TibeKnuts001/Round-chessboard/hardware/Pictures/DSC_0005.JPG

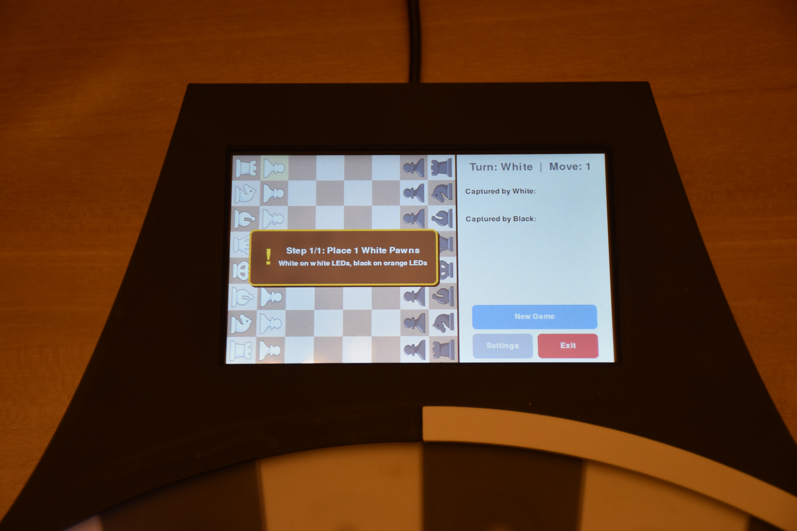
hardware/Pictures/DSC_0005.JPG
