TibeKnuts001/Round-chessboard/hardware/Pictures/DSC_0003.JPG

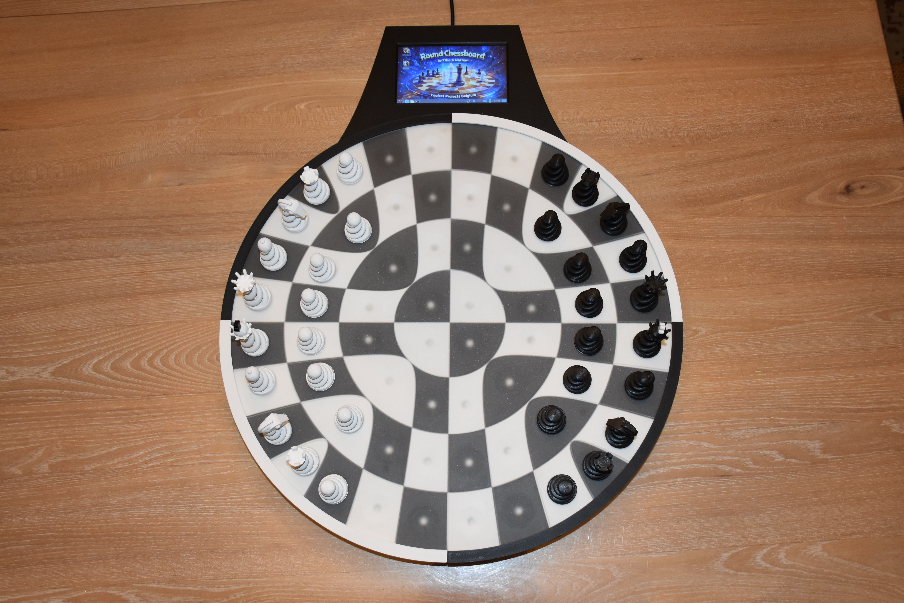
hardware/Pictures/DSC_0003.JPG
