TibeKnuts001/Round-chessboard/assets/checkers_pieces/black_king.png

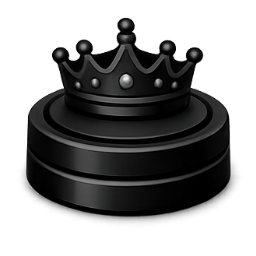
assets/checkers_pieces/black_king.png
