TibeKnuts001/Round-chessboard/assets/checkers_pieces/black_man.png

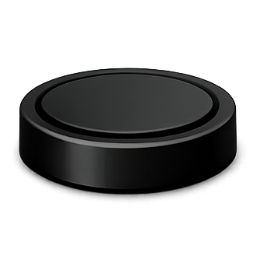
assets/checkers_pieces/black_man.png
