TibeKnuts001/Round-chessboard/assets/checkers_pieces/checkers_original_by_chatgpt.png

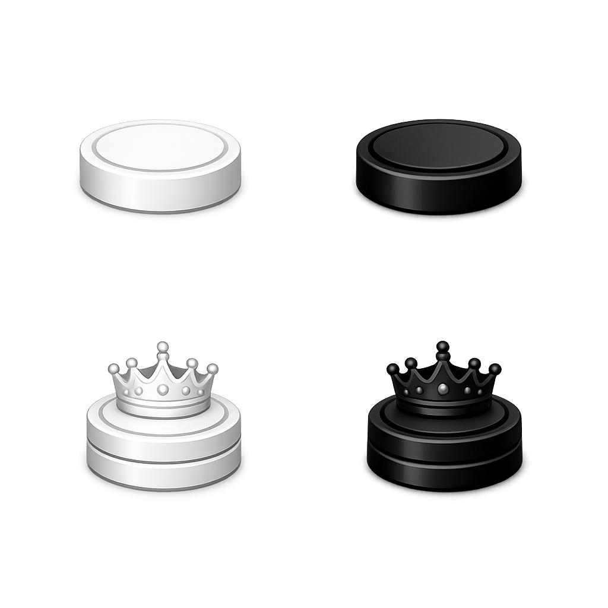
assets/checkers_pieces/checkers_original_by_chatgpt.png
