TibeKnuts001/Round-chessboard/assets/checkers_pieces/white_king.png

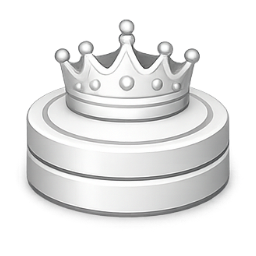
assets/checkers_pieces/white_king.png
