TibeKnuts001/Round-chessboard/assets/checkers_pieces/white_man.png

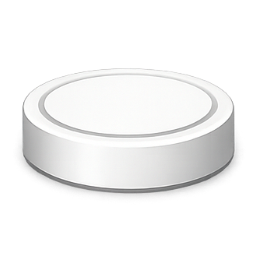
assets/checkers_pieces/white_man.png
