TibeKnuts001/Round-chessboard/assets/chess_pieces/black_bishop.png

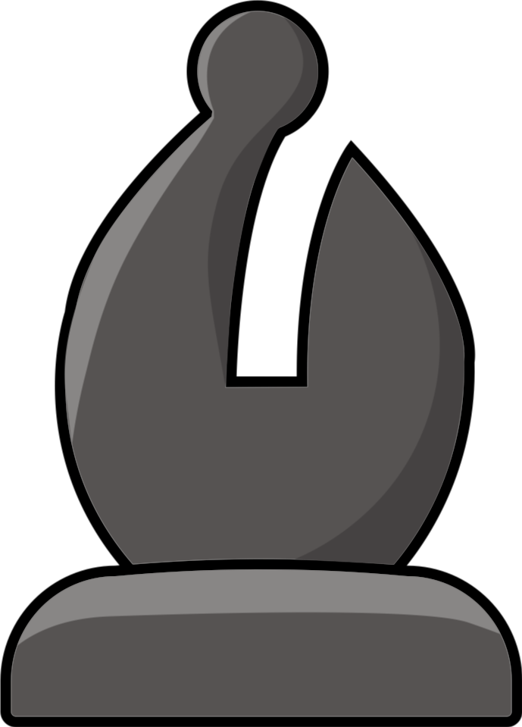
assets/chess_pieces/black_bishop.png
