TibeKnuts001/Round-chessboard/assets/chess_pieces/black_king.png

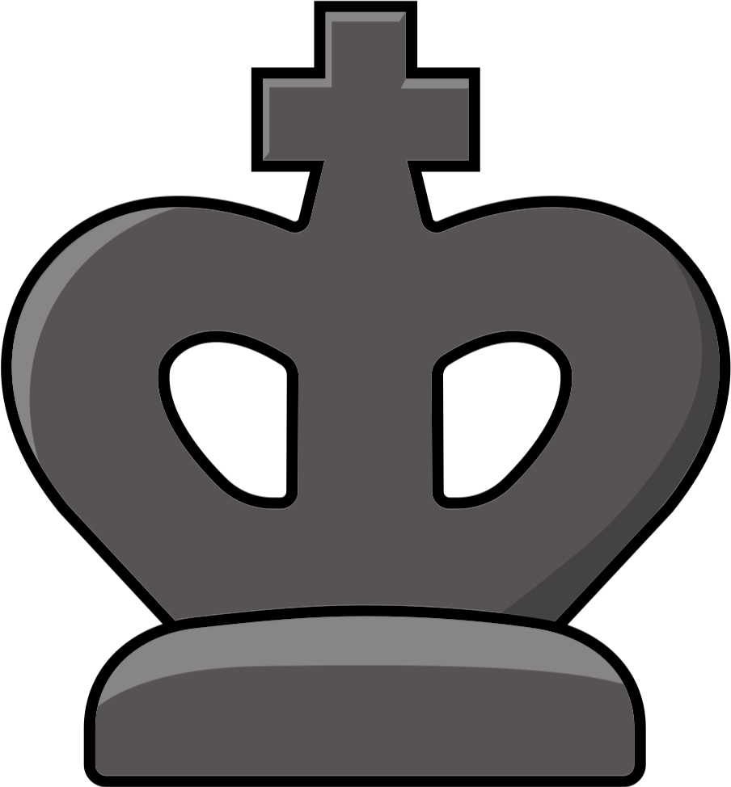
assets/chess_pieces/black_king.png
