TibeKnuts001/Round-chessboard/assets/chess_pieces/black_knight.png

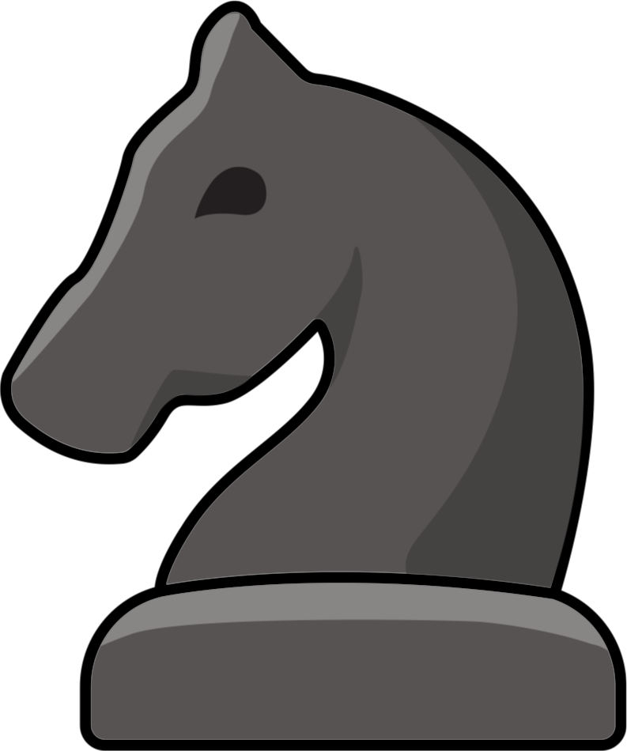
assets/chess_pieces/black_knight.png
