TibeKnuts001/Round-chessboard/assets/chess_pieces/black_pawn.png

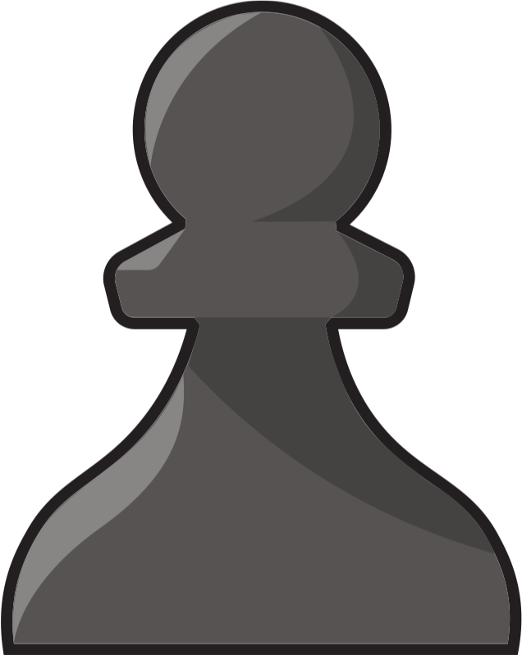
assets/chess_pieces/black_pawn.png
