TibeKnuts001/Round-chessboard/assets/chess_pieces/black_queen.png

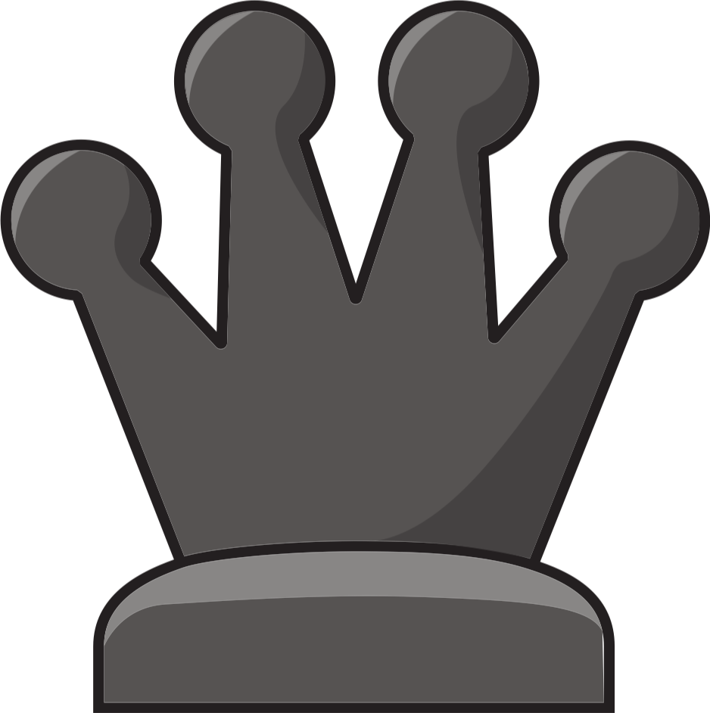
assets/chess_pieces/black_queen.png
