TibeKnuts001/Round-chessboard/assets/chess_pieces/black_rook.png

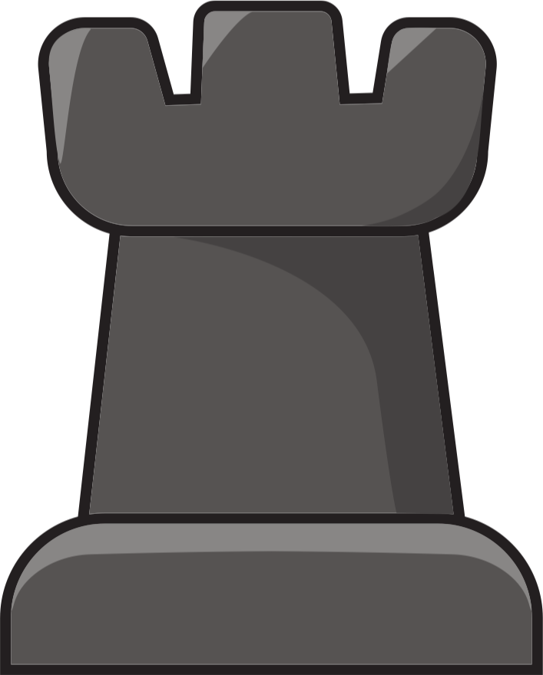
assets/chess_pieces/black_rook.png
