TibeKnuts001/Round-chessboard/assets/chess_pieces/white_bishop.png

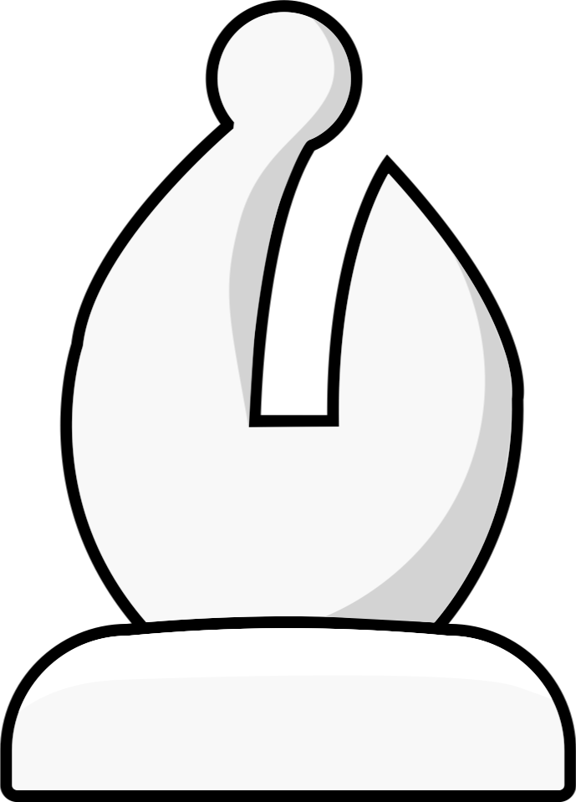
assets/chess_pieces/white_bishop.png
