TibeKnuts001/Round-chessboard/assets/chess_pieces/white_king.png

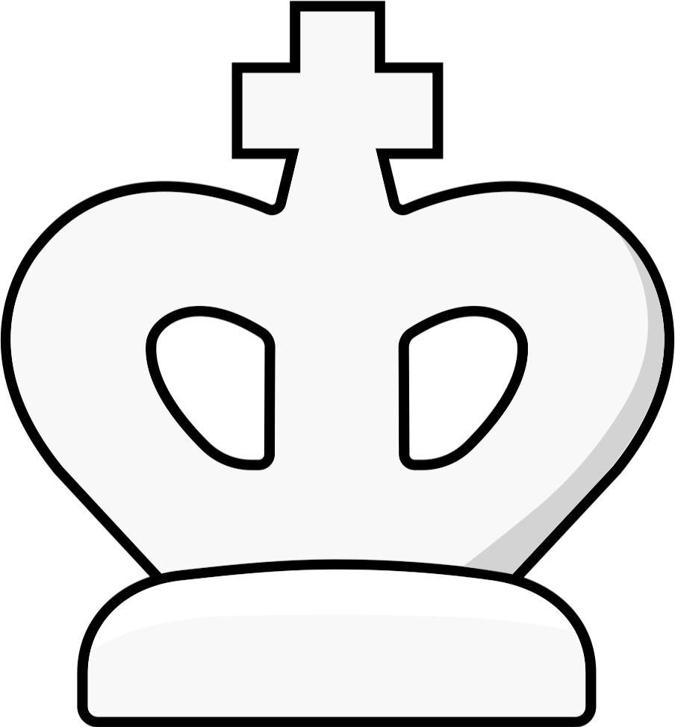
assets/chess_pieces/white_king.png
