TibeKnuts001/Round-chessboard/assets/chess_pieces/white_knight.png

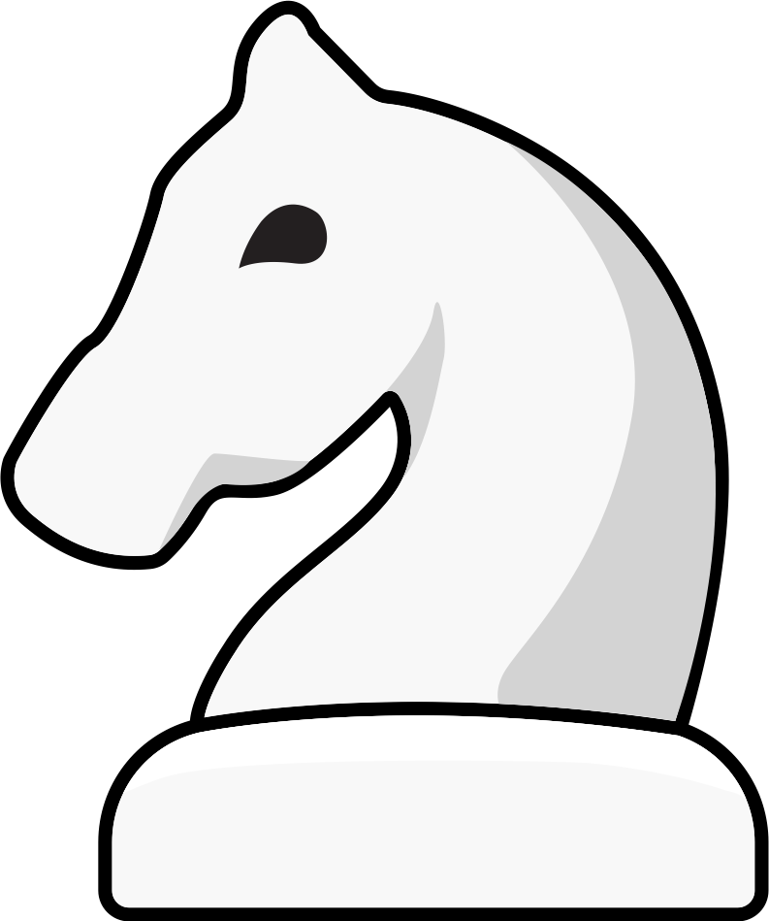
assets/chess_pieces/white_knight.png
