TibeKnuts001/Round-chessboard/assets/chess_pieces/white_pawn.png

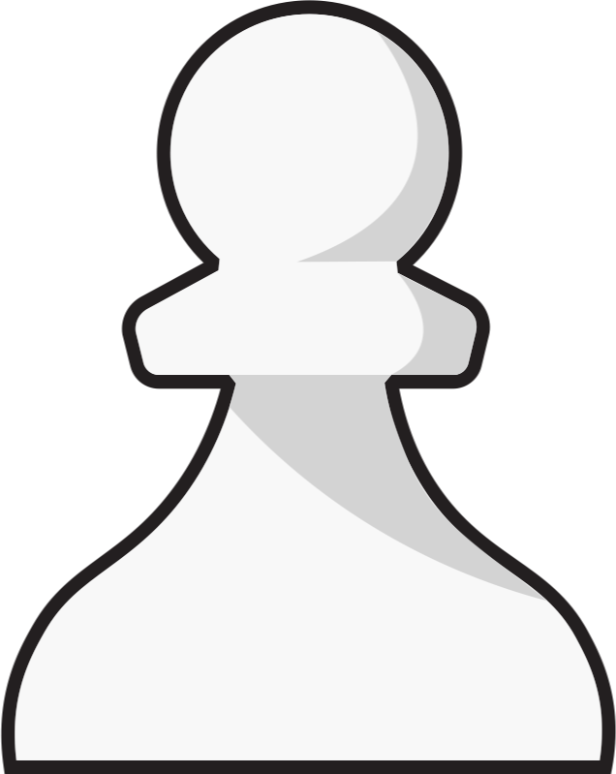
assets/chess_pieces/white_pawn.png
