TibeKnuts001/Round-chessboard/assets/chess_pieces/white_queen.png

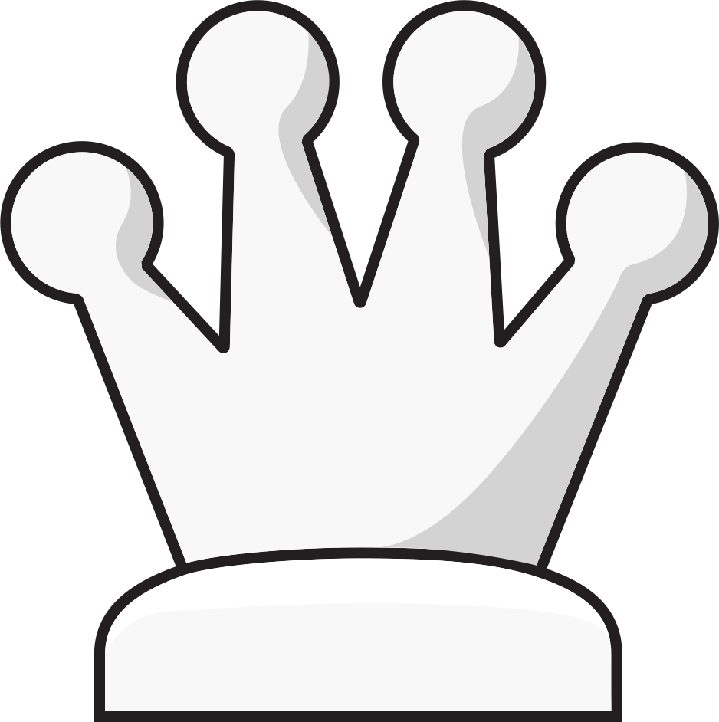
assets/chess_pieces/white_queen.png
