TibeKnuts001/Round-chessboard/assets/chess_pieces/white_rook.png

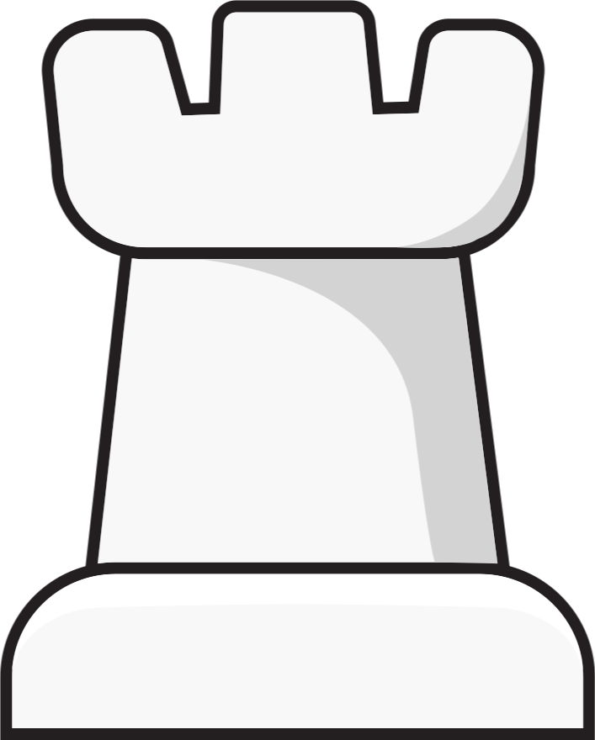
assets/chess_pieces/white_rook.png
