TibeKnuts001/Round-chessboard/assets/screensaver/screensaver.png

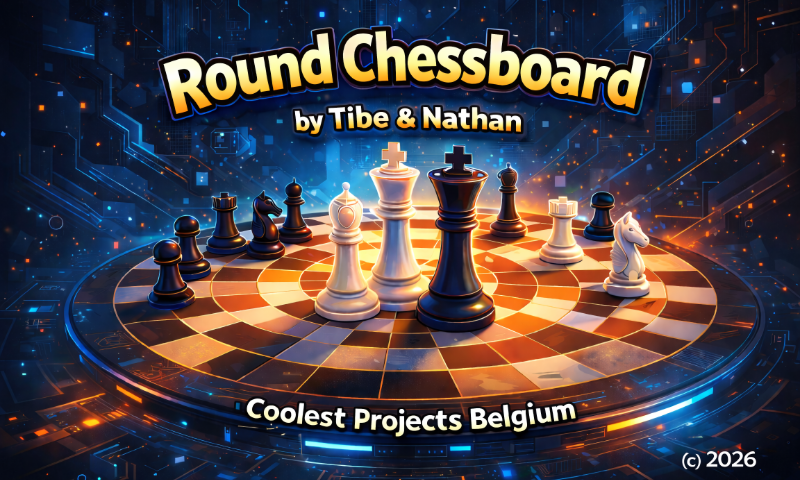
assets/screensaver/screensaver.png
