TibeKnuts001/Round-chessboard/assets/switch.png

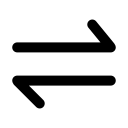
assets/switch.png
