TibeKnuts001/Round-chessboard/hardware/Pictures/DSC_0001.JPG

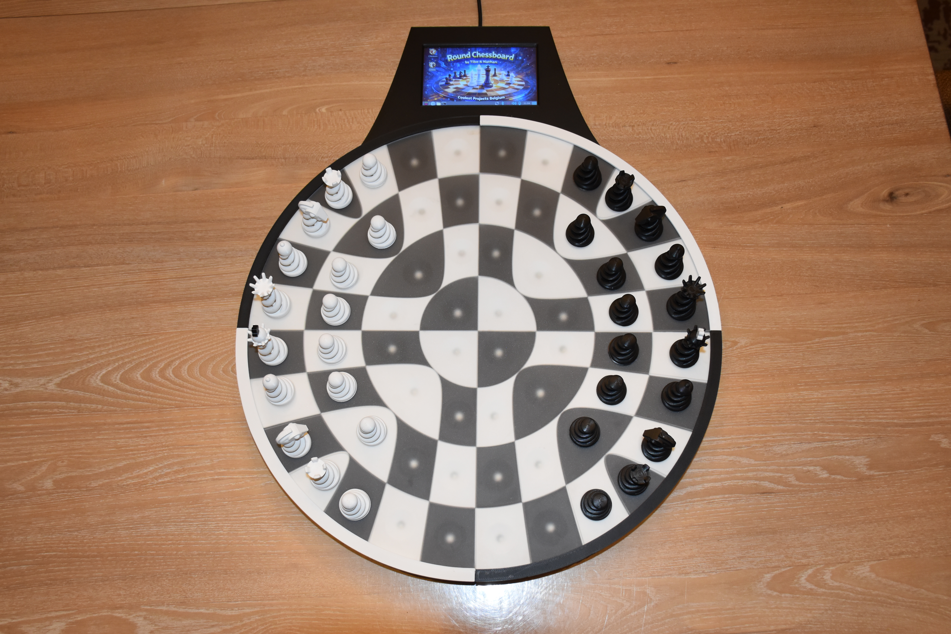
hardware/Pictures/DSC_0001.JPG
