TibeKnuts001/Round-chessboard/hardware/Pictures/DSC_0006.JPG

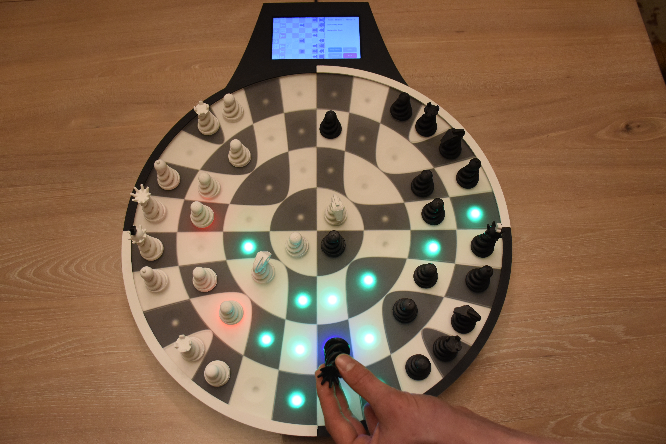
hardware/Pictures/DSC_0006.JPG
