TibeKnuts001/Round-chessboard/hardware/Pictures/DSC_0008.JPG

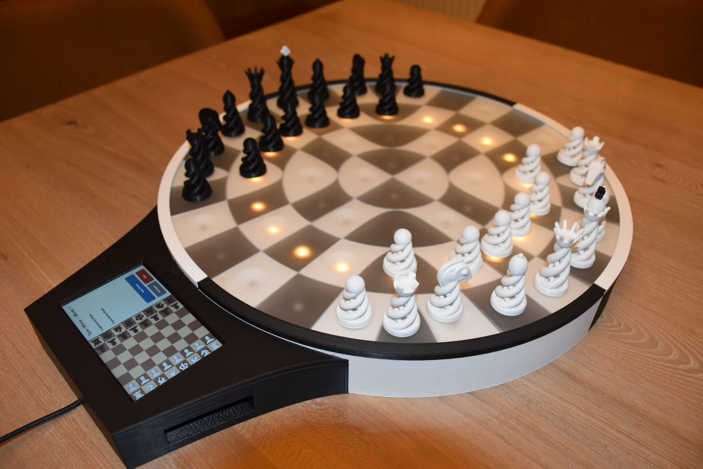
hardware/Pictures/DSC_0008.JPG
