TibeKnuts001/Round-chessboard/hardware/Pictures/DSC_0009.JPG

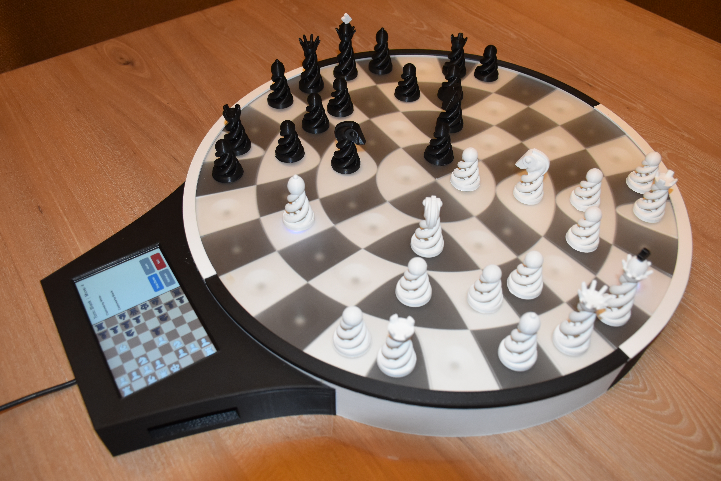
hardware/Pictures/DSC_0009.JPG
