TibeKnuts001/Round-chessboard/hardware/Pictures/DSC_0010.JPG

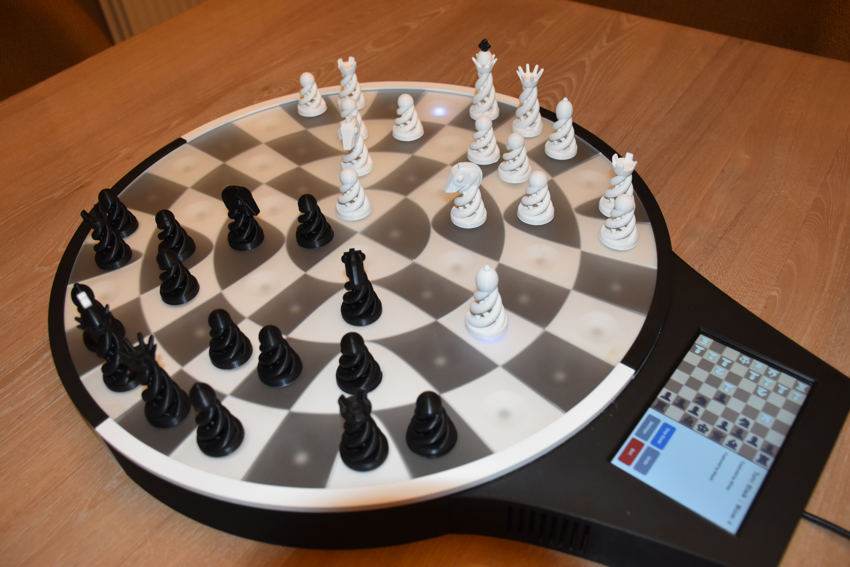
hardware/Pictures/DSC_0010.JPG
