TibeKnuts001/Round-chessboard/hardware/3D files/Checkers/Checker piece.stl

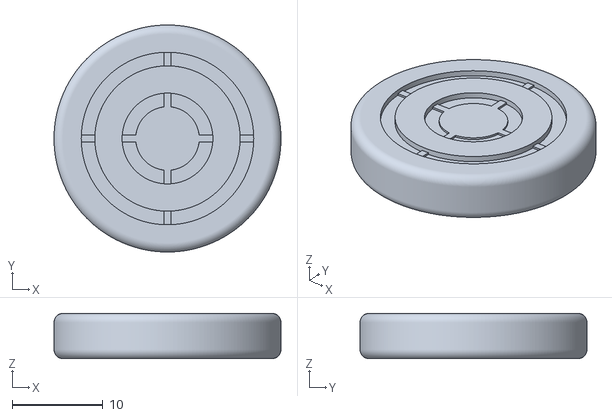
[picture p27: CAD file, 2026-03-11]
hardware/3D files/Checkers/Checker piece.stl
25.0 x 25.0 x 5.00
