TibeKnuts001/Round-chessboard/hardware/3D files/Chessboard/spiral chess pieces.stl

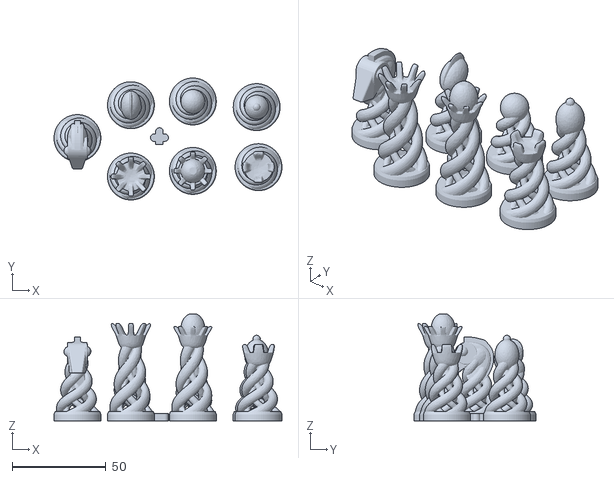
[picture p28: CAD file, 2026-03-25]
hardware/3D files/Chessboard/spiral chess pieces.stl
121.5 x 65.0 x 57.0
