TibeKnuts001/Round-chessboard/hardware/3D files/Chessboard/schermpje met gat stroom.stl

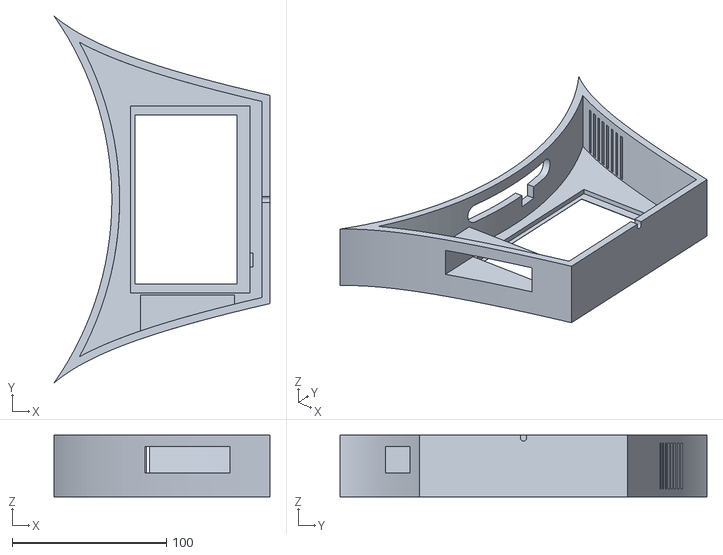
[picture p29: CAD file, 2026-03-11]
hardware/3D files/Chessboard/schermpje met gat stroom.stl
140.0 x 238.0 x 40.0
