TibeKnuts001/Round-chessboard/hardware/3D files/Chessboard/chess+board+rand.stl

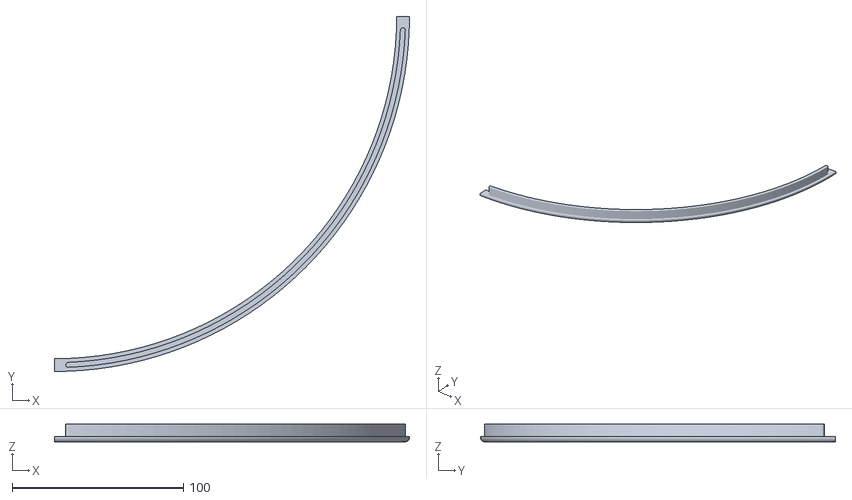
[picture p30: CAD file, 2026-03-11]
hardware/3D files/Chessboard/chess+board+rand.stl
207.5 x 207.5 x 10.3
