TibeKnuts001/Round-chessboard/hardware/3D files/Chessboard/inlays.stl

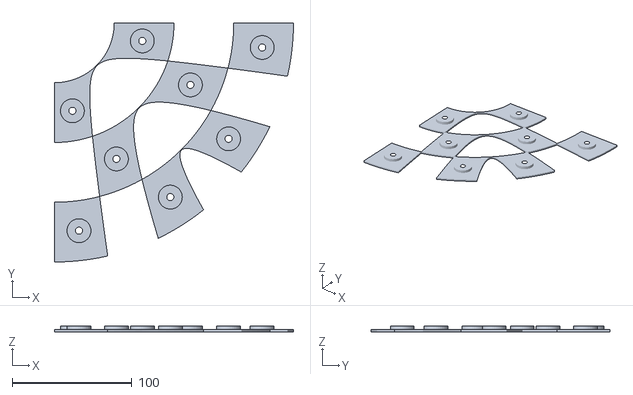
[picture p31: CAD file, 2026-03-11]
hardware/3D files/Chessboard/inlays.stl
200.0 x 200.0 x 5.00
