TibeKnuts001/Round-chessboard/hardware/3D files/Chessboard/Buiten rand ZWART.stl

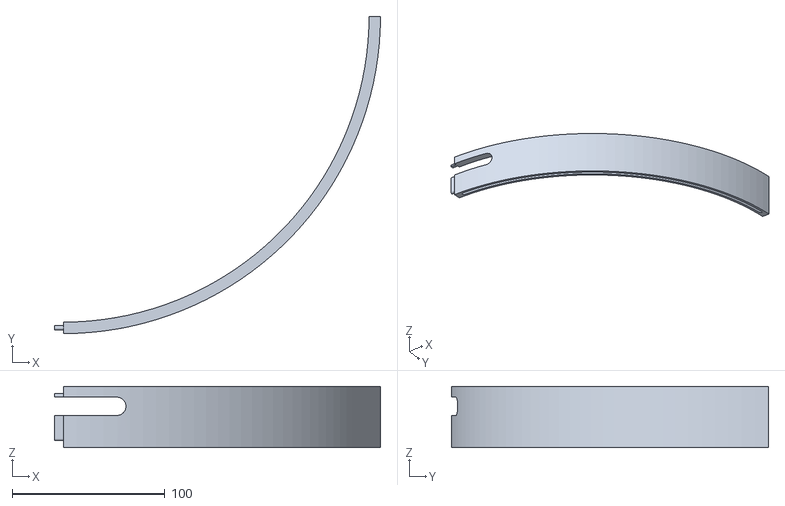
[picture p32: CAD file, 2026-03-11]
hardware/3D files/Chessboard/Buiten rand ZWART.stl
213.2 x 207.5 x 40.0
