TibeKnuts001/Round-chessboard/hardware/3D files/Chessboard/chess+board+boven+rand.stl

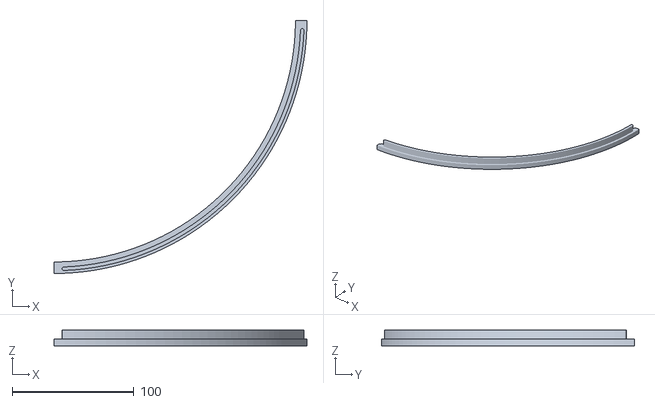
[picture p33: CAD file, 2026-03-11]
hardware/3D files/Chessboard/chess+board+boven+rand.stl
207.5 x 207.5 x 12.8
