TibeKnuts001/Round-chessboard/hardware/3D files/Chessboard/board.stl

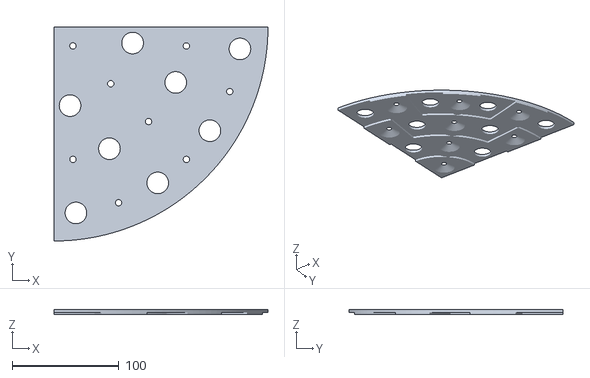
[picture p34: CAD file, 2026-03-11]
hardware/3D files/Chessboard/board.stl
200.0 x 200.0 x 5.00
