TibeKnuts001/Round-chessboard/(list of files, cad)

Other CAD files:
hardware/3D files/Chessboard/Buiten rand WIT.stl
hardware/3D files/Chessboard/schermpje.stl
