TibeKnuts001/Round-chessboard/hardware/PCB files/chessboard.kicad_pcb

## KiCad design hardware/PCB files/chessboard.kicad_pcb (2026-03-13)

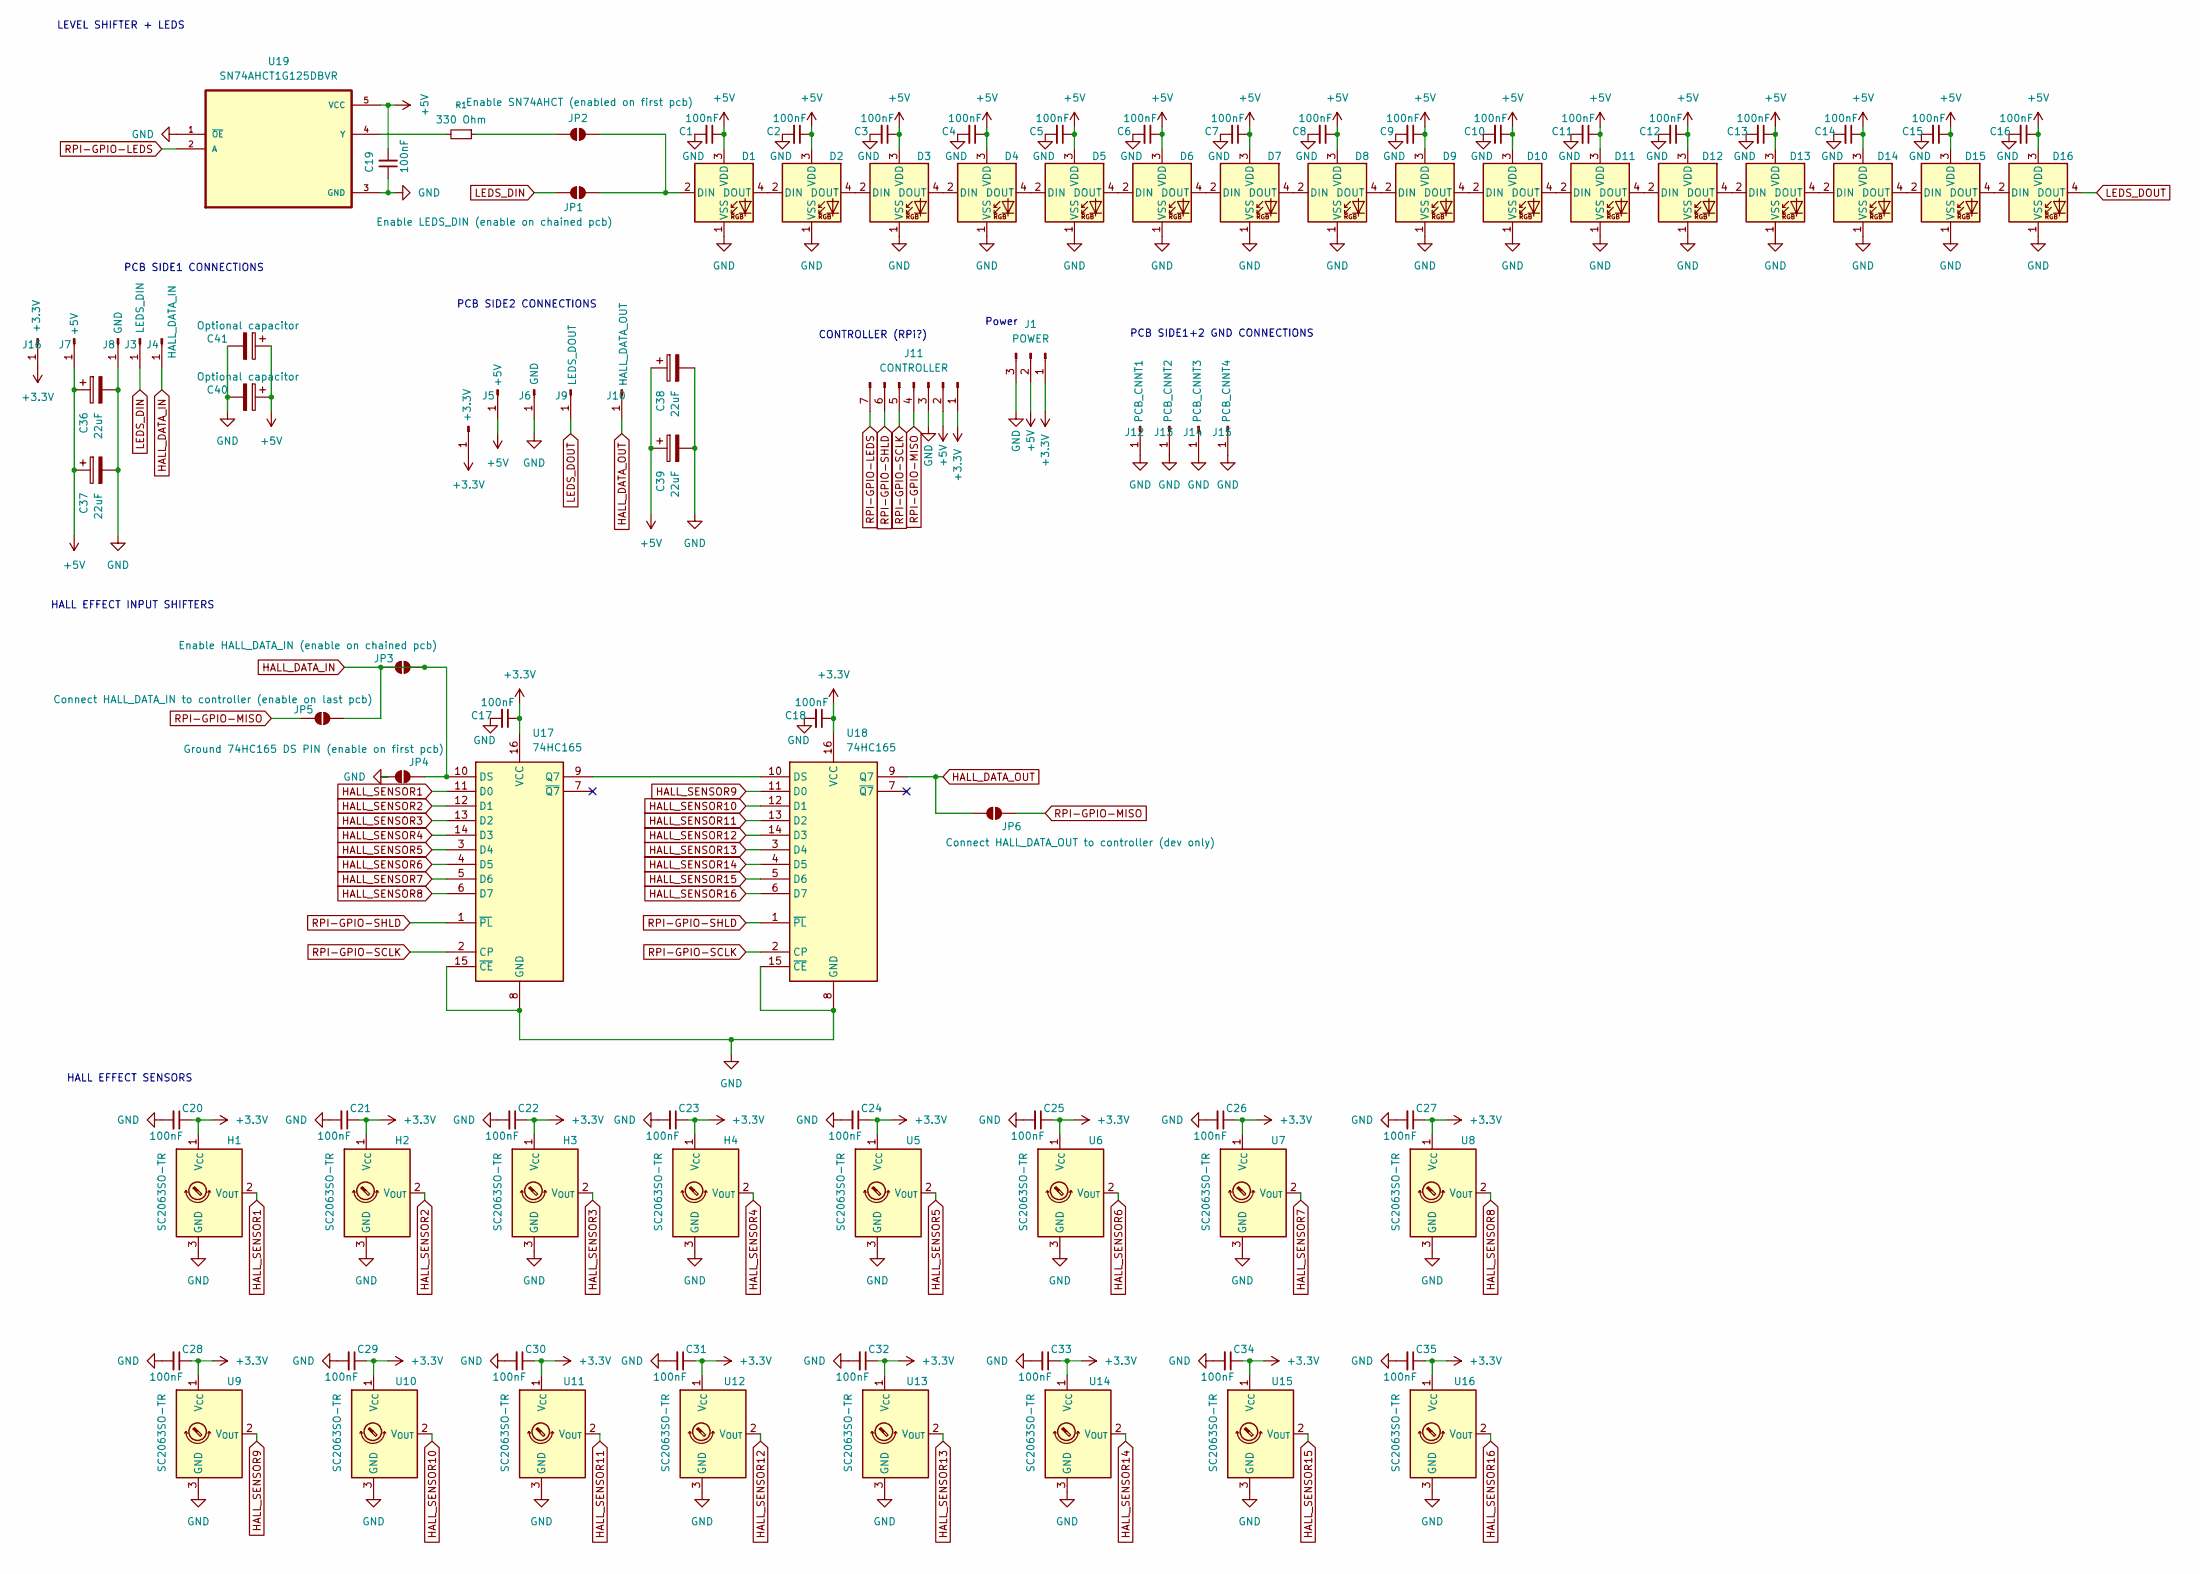
[picture p35: schematic chessboard.kicad_sch]

Parts:
C1, C2, C3, C4, C5, C6, C7, C8, C9, C10, C11, C12, C13, C14, C15, C16, C17, C18, C19, C20, C21, C22, C23, C24, C25, C26, C27, C28, C29, C30, C31, C32, C33, C34, C35: 100nF; C_0603_1608Metric
C36, C37, C38, C39: 22uF; C_1206_3216Metric
C40, C41: Optional capacitor; CP_Radial_D8.0mm_P3.50mm
D1, D2, D3, D4, D5, D6, D7, D8, D9, D10, D11, D12, D13, D14, D15, D16: SK5812; LED_SK6812_PLCC4_5.0x5.0mm_P3.2mm
H1, H2, H3, H4: SC2063SO-TR; SOT-23
J1: POWER; SolderWire-0.5sqmm_1x03_P4.6mm_D0.9mm_OD2.1mm_Relief
J3: LEDS_DIN; SolderWirePad_1x01_SMD_4x8mm
J4: HALL_DATA_IN; SolderWirePad_1x01_SMD_4x8mm
J5, J7: +5V; SolderWirePad_1x01_SMD_4x8mm
J6, J8: GND; SolderWirePad_1x01_SMD_4x8mm
J9: LEDS_DOUT; SolderWirePad_1x01_SMD_4x8mm
J10: HALL_DATA_OUT; SolderWirePad_1x01_SMD_4x8mm
J11: CONTROLLER; SolderWire-0.1sqmm_1x06_P3.6mm_D0.4mm_OD1mm_Relief_1__SCHAA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
J12: PCB_CNNT1; SolderWirePad_1x01_SMD_4x8mm
J13: PCB_CNNT2; SolderWirePad_1x01_SMD_4x8mm
J14: PCB_CNNT3; SolderWirePad_1x01_SMD_4x8mm
J15: PCB_CNNT4; SolderWirePad_1x01_SMD_4x8mm
J16, J17: +3.3V; SolderWirePad_1x01_SMD_4x8mm
JP1: Enable LEDS_DIN (enable on chained pcb); SolderJumper-2_P1.3mm_Open_RoundedPad1.0x1.5mm
JP2: Enable SN74AHCT (enabled on first pcb); SolderJumper-2_P1.3mm_Open_RoundedPad1.0x1.5mm
JP3: Enable HALL_DATA_IN (enable on chained pcb); SolderJumper-2_P1.3mm_Open_RoundedPad1.0x1.5mm
JP4: Ground 74HC165 DS PIN (enable on first pcb); SolderJumper-2_P1.3mm_Open_RoundedPad1.0x1.5mm
JP5: Connect HALL_DATA_IN to controller (enable on las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; SolderJumper-2_P1.3mm_Open_RoundedPad1.0x1.5mm
JP6: Connect HALL_DATA_OUT to controller (dev only); SolderJumper-2_P1.3mm_Open_RoundedPad1.0x1.5mm
R1: 330 Ohm; R_0603_1608Metric
U5, U6, U7, U8, U9, U10, U11, U12, U13, U14, U15, U16: SC2063SO-TR; SOT-23
U17, U18: 74HC165; SOP-16_4.4x10.4mm_P1.27mm
U19: SN74AHCT1G125DBVR; SOT95P280X145-5N

Connections:
+3.3V: C17.1, C18.1, C20.1, C21.1, C22.1, C23.1, C24.1, C25.1, C26.1, C27.1, C28.1, C29.1, C30.1, C31.1, C32.1, C33.1, C34.1, C35.1, H1.1 (V_{CC}), H2.1 (V_{CC}), H3.1 (V_{CC}), H4.1 (V_{CC}), J1.1, J11.1, J16.1, J17.1, U5.1 (V_{CC}), U6.1 (V_{CC}), U7.1 (V_{CC}), U8.1 (V_{CC}), U9.1 (V_{CC}), U10.1 (V_{CC}), U11.1 (V_{CC}), U12.1 (V_{CC}), U13.1 (V_{CC}), U14.1 (V_{CC}), U15.1 (V_{CC}), U16.1 (V_{CC}), U17.16 (VCC), U18.16 (VCC)
+5V: C1.1, C2.1, C3.1, C4.1, C5.1, C6.1, C7.1, C8.1, C9.1, C10.1, C11.1, C12.1, C13.1, C14.1, C15.1, C16.1, C19.2, C36.1, C37.1, C38.1, C39.1, C40.1, C41.1, D1.3 (VDD), D2.3 (VDD), D3.3 (VDD), D4.3 (VDD), D5.3 (VDD), D6.3 (VDD), D7.3 (VDD), D8.3 (VDD), D9.3 (VDD), D10.3 (VDD), D11.3 (VDD), D12.3 (VDD), D13.3 (VDD), D14.3 (VDD), D15.3 (VDD), D16.3 (VDD), J1.2, J5.1, J7.1, J11.2, U19.5 (VCC)
GND: C1.2, C2.2, C3.2, C4.2, C5.2, C6.2, C7.2, C8.2, C9.2, C10.2, C11.2, C12.2, C13.2, C14.2, C15.2, C16.2, C17.2, C18.2, C19.1, C20.2, C21.2, C22.2, C23.2, C24.2, C25.2, C26.2, C27.2, C28.2, C29.2, C30.2, C31.2, C32.2, C33.2, C34.2, C35.2, C36.2, C37.2, C38.2, C39.2, C40.2, C41.2, D1.1 (VSS), D2.1 (VSS), D3.1 (VSS), D4.1 (VSS), D5.1 (VSS), D6.1 (VSS), D7.1 (VSS), D8.1 (VSS), D9.1 (VSS), D10.1 (VSS), D11.1 (VSS), D12.1 (VSS), D13.1 (VSS), D14.1 (VSS), D15.1 (VSS), D16.1 (VSS), H1.3 (GND), H2.3 (GND), H3.3 (GND), H4.3 (GND), J1.3, J6.1, J8.1, J11.3, J12.1, J13.1, J14.1, J15.1, JP4.1 (A), U5.3 (GND), U6.3 (GND), U7.3 (GND), U8.3 (GND), U9.3 (GND), U10.3 (GND), U11.3 (GND), U12.3 (GND), U13.3 (GND), U14.3 (GND), U15.3 (GND), U16.3 (GND), U17.8 (GND), U17.15 (~CE), U18.8 (GND), U18.15 (~CE), U19.1 (~OE), U19.3 (GND)
HALL_DATA_OUT: J10.1, JP6.1 (A), U18.9 (Q7)
HALL_SENSOR1: H1.2 (V_{OUT}), U17.11 (D0)
HALL_SENSOR2: H2.2 (V_{OUT}), U17.12 (D1)
HALL_SENSOR3: H3.2 (V_{OUT}), U17.13 (D2)
HALL_SENSOR4: H4.2 (V_{OUT}), U17.14 (D3)
HALL_SENSOR5: U5.2 (V_{OUT}), U17.3 (D4)
HALL_SENSOR6: U6.2 (V_{OUT}), U17.4 (D5)
HALL_SENSOR7: U7.2 (V_{OUT}), U17.5 (D6)
HALL_SENSOR8: U8.2 (V_{OUT}), U17.6 (D7)
HALL_SENSOR9: U9.2 (V_{OUT}), U18.11 (D0)
HALL_SENSOR10: U10.2 (V_{OUT}), U18.12 (D1)
HALL_SENSOR11: U11.2 (V_{OUT}), U18.13 (D2)
HALL_SENSOR12: U12.2 (V_{OUT}), U18.14 (D3)
HALL_SENSOR13: U13.2 (V_{OUT}), U18.3 (D4)
HALL_SENSOR14: U14.2 (V_{OUT}), U18.4 (D5)
HALL_SENSOR15: U15.2 (V_{OUT}), U18.5 (D6)
HALL_SENSOR16: U16.2 (V_{OUT}), U18.6 (D7)
LEDS_DIN: J3.1, JP1.2 (B)
LEDS_DOUT: D16.4 (DOUT), J9.1
unnamed: D1.2 (DIN), JP1.1 (A), JP2.2 (B)
unnamed: D1.4 (DOUT), D2.2 (DIN)
unnamed: D2.4 (DOUT), D3.2 (DIN)
unnamed: D3.4 (DOUT), D4.2 (DIN)
unnamed: D4.4 (DOUT), D5.2 (DIN)
unnamed: D5.4 (DOUT), D6.2 (DIN)
unnamed: D6.4 (DOUT), D7.2 (DIN)
unnamed: D7.4 (DOUT), D8.2 (DIN)
unnamed: D8.4 (DOUT), D9.2 (DIN)
unnamed: D9.4 (DOUT), D10.2 (DIN)
unnamed: D10.4 (DOUT), D11.2 (DIN)
unnamed: D11.4 (DOUT), D12.2 (DIN)
unnamed: D12.4 (DOUT), D13.2 (DIN)
unnamed: D13.4 (DOUT), D14.2 (DIN)
unnamed: D14.4 (DOUT), D15.2 (DIN)
unnamed: D15.4 (DOUT), D16.2 (DIN)
unnamed: JP2.1 (A), R1.1
unnamed: U17.9 (Q7), U18.10 (DS)
unnamed: R1.2, U19.4 (Y)
RPI-GPIO-LEDS: J11.7, U19.2 (A)
RPI-GPIO-MISO: J11.4, JP5.2 (B), JP6.2 (B)
RPI-GPIO-SCLK: J11.5, U17.2 (CP), U18.2 (CP); also elsewhere on the board
RPI-GPIO-SHLD: J11.6, U17.1 (~PL), U18.1 (~PL); also elsewhere on the board

Notes on the sheet:
CONTROLLER (RPi?)
PCB SIDE1 CONNECTIONS
Power
PCB SIDE1+2 GND CONNECTIONS
PCB SIDE2 CONNECTIONS
HALL EFFECT INPUT SHIFTERS
HALL EFFECT SENSORS
LEVEL SHIFTER + LEDS

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
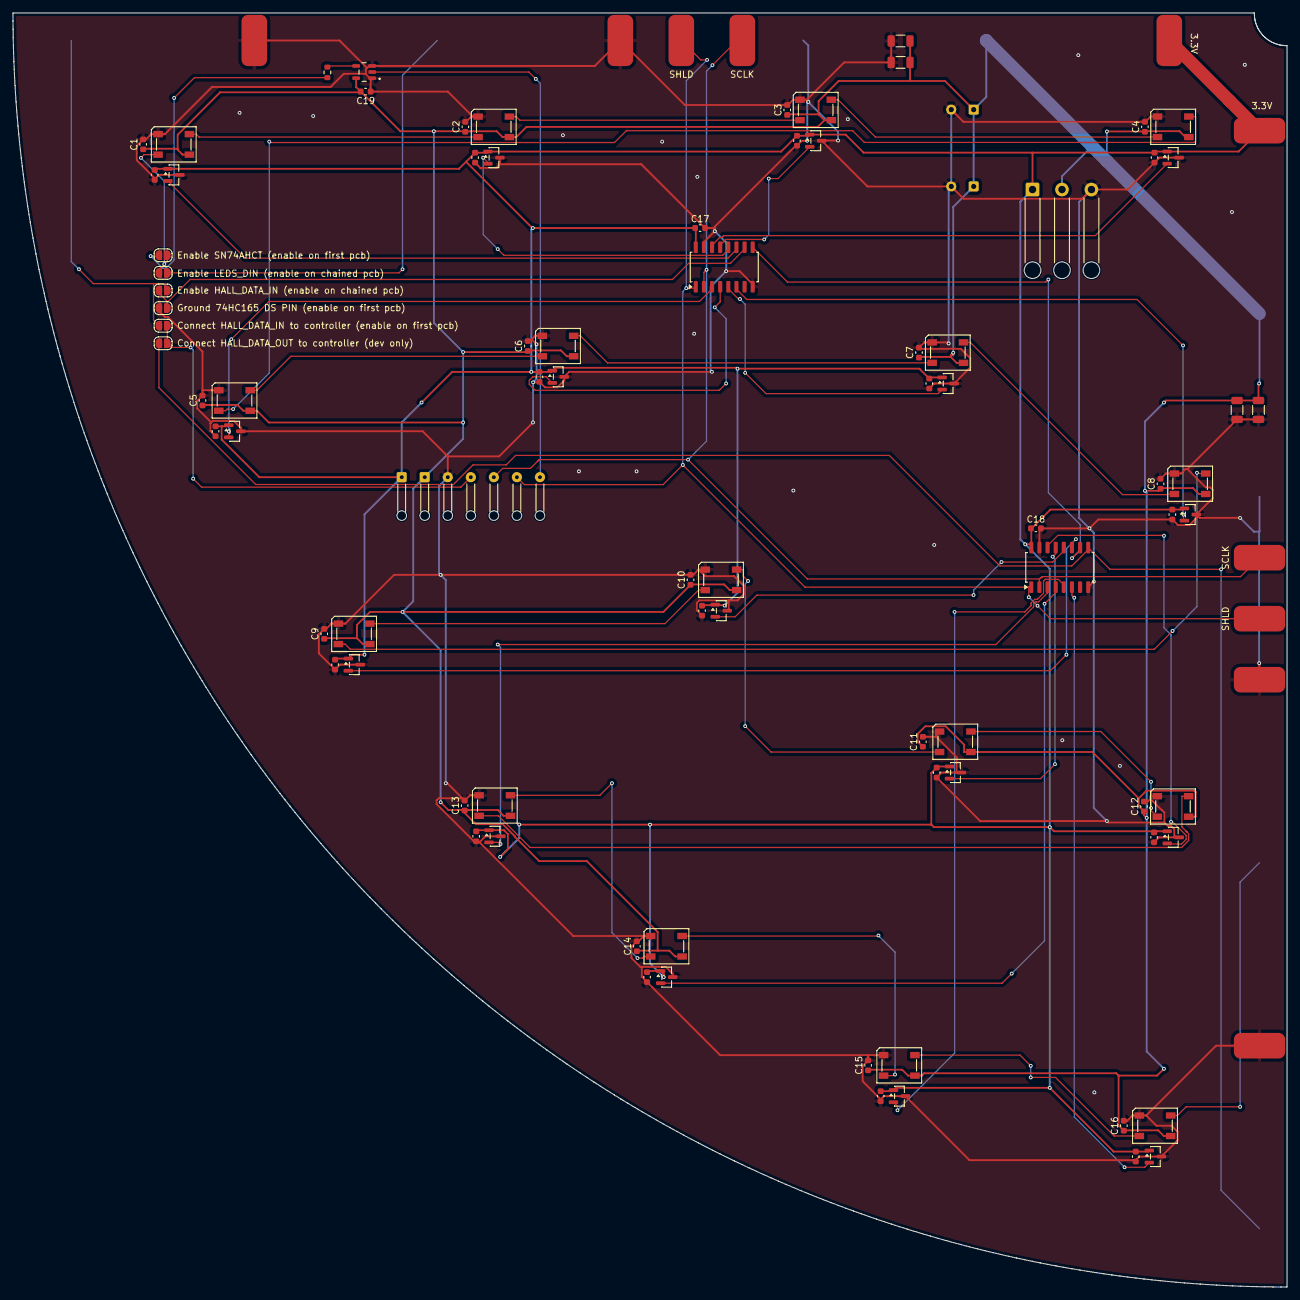
[picture p36: board chessboard.kicad_pcb from above]

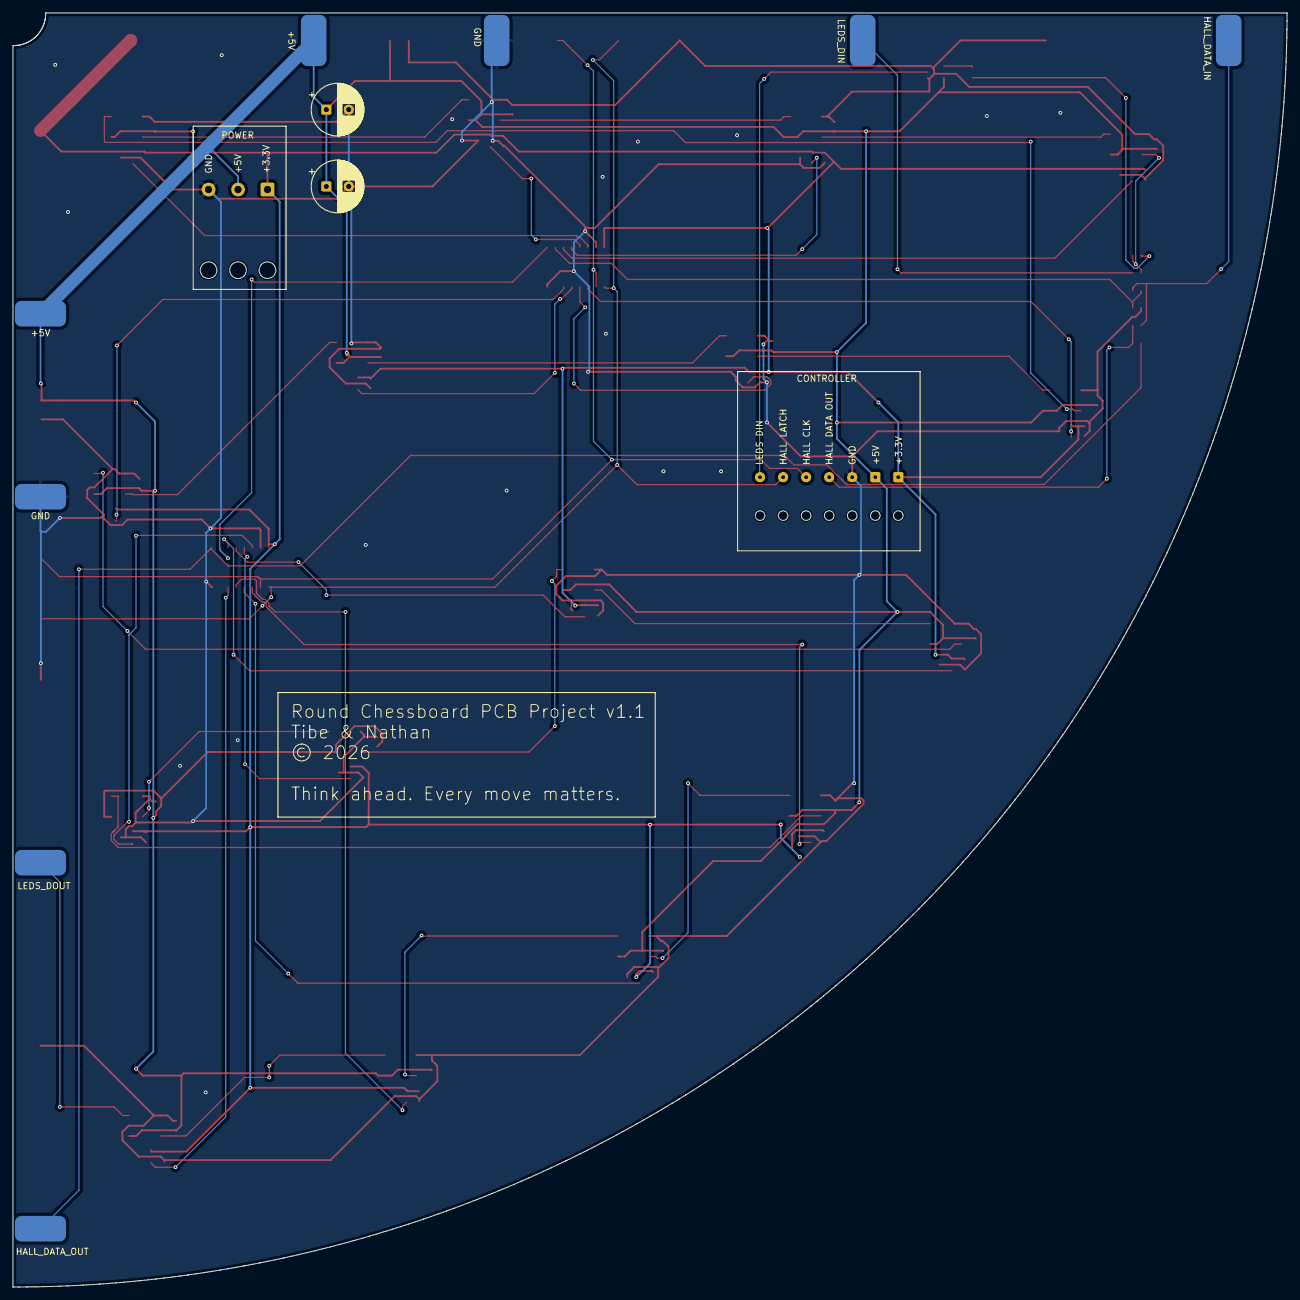
[picture p37: board chessboard.kicad_pcb from below]

Board: 2 copper layers, 199.0 x 199.0 mm, 103 parts (10 on the bottom side), 47 nets.

Other parts of the board:
J2, J19: SHLD; SolderWirePad_1x01_SMD_4x8mm
J18, J20: SCLK; SolderWirePad_1x01_SMD_4x8mm

Their connections:
RPI-GPIO-SCLK: J18.1, J20.1; also elsewhere on the board
RPI-GPIO-SHLD: J2.1, J19.1; also elsewhere on the board
