TibeKnuts001/Round-chessboard/(commit log)

2026-02-07 validate board state werk met effecten
2026-02-07 valdiate board state zit in main game loop
2026-02-07 je kan spelen terwijl validite board state aan stat
2026-02-14 rotated board
2026-02-16 stockfish + rotate board
2026-02-16 board mismatch when extra pieces
2026-02-17 castel leds
2026-02-17 more led effects
2026-02-17 assisted setup for any board
2026-03-06 enhanced game over detection and LED feedback for checkmate and wins
2026-03-06 add hide board display feature: implement toggle for chess and checkers to hide board and highlights
2026-03-06 Add color selection dialog for Checkers and Chess games
    - Introduced a color selection dialog in both CheckersGUI and ChessGUI to allow players to choose their sides before starting a new game.
    - Added logic to handle the orientation of the board based on the selected color.
    - Updated the rendering of the game board to rotate correctly depending on the player's choice.
    - Implemented functionality for AI to choose a color when playing against the computer.
    - Added a switch icon for swapping colors in the dialog.
    - Included a new asset for the switch icon used in the color selection dialog.
2026-03-08 fixed intermiated leds not showing for checker AI move
2026-03-11 Added checker's 3D files
    [Checker piece.stl]
2026-03-13 feat: Add base HTML template and index page for draughts game
    - Created a base HTML template (`base.html`) for consistent layout across pages.
    - Developed an index page (`index.html`) that extends the base template, featuring game controls, board area, and move list.
    - Integrated Bootstrap 5.3 for styling and layout.
    - Added jQuery for game logic support.
    feat: Implement SVG rendering for draughts boards
    - Introduced `svg.py` for rendering draughts boards as SVG images.
    - Supported 8×8 and 10×10 board variants, piece rendering, move highlighting, and annotations.
    - Included functions for rendering pieces, boards, and arrows.
    feat: Generate pre-computed attack tables for pieces
    - Added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
2026-03-13 Add support for switching between chess and checkers games with exit confirmation dialog updates
2026-03-13 moved files
    [Buiten rand WIT.stl, Buiten rand ZWART.stl, Checker piece.stl, board.stl, chess+board+boven+rand.stl, chess+board+rand.stl, chessboard.kicad_pcb, chessboard.kicad_sch]
