TibeKnuts001/Round-chessboard/(notices)

Notices in the files:
hardware/PCB files/chessboard.kicad_pcb:
© 2026
